pslavkin/cese_kicad/README.md

# cese_kicad
tp para cese sobre kicad

Autor: Pablo Slavkin
CESE2018

Driver motores paso a paso
===========================

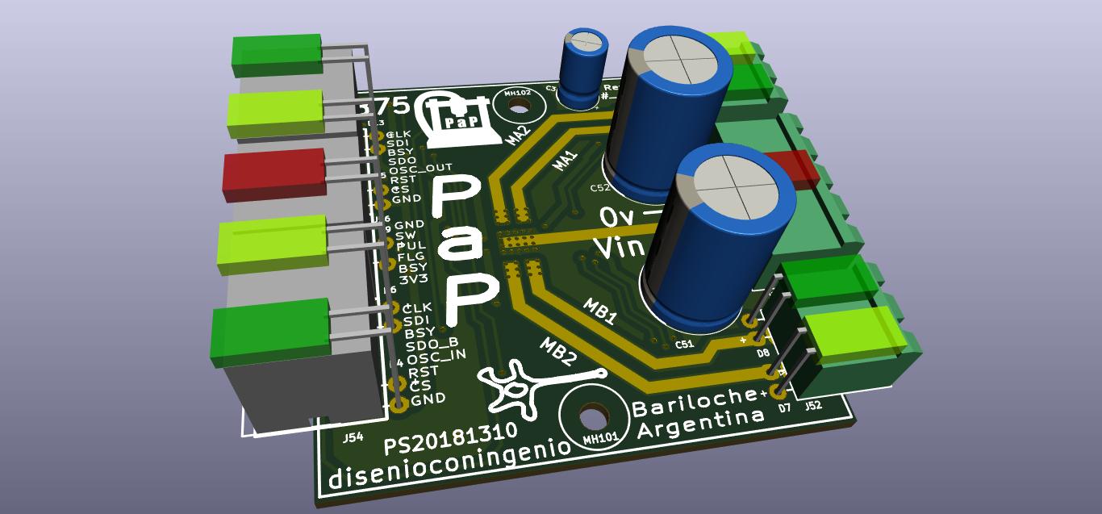
[picture p1: pics/vista3d_1.jpg]
Vista 3d
