pslavkin/cese_kicad/pics/bottom.png

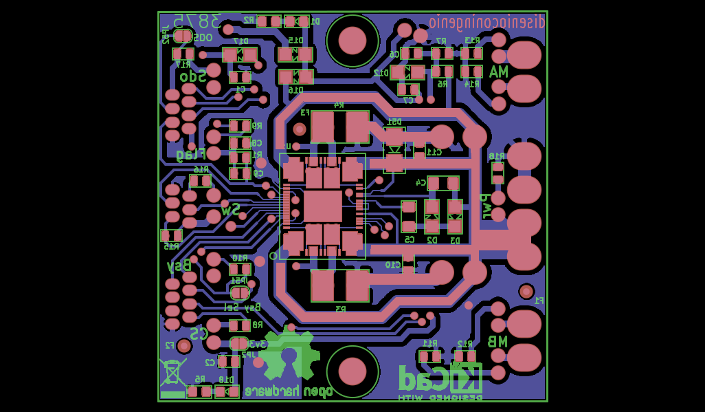
pics/bottom.png
