pslavkin/cese_kicad/pics/top.png

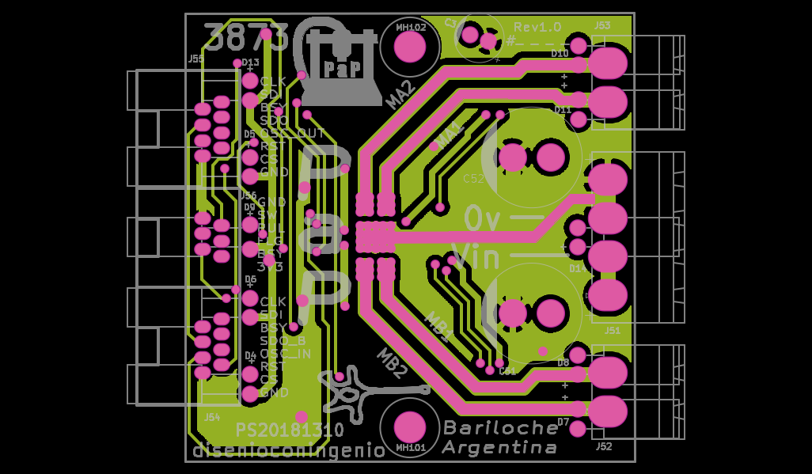
pics/top.png
