pslavkin/cese_kicad/3d/led_5x2_enchufable.fcstd

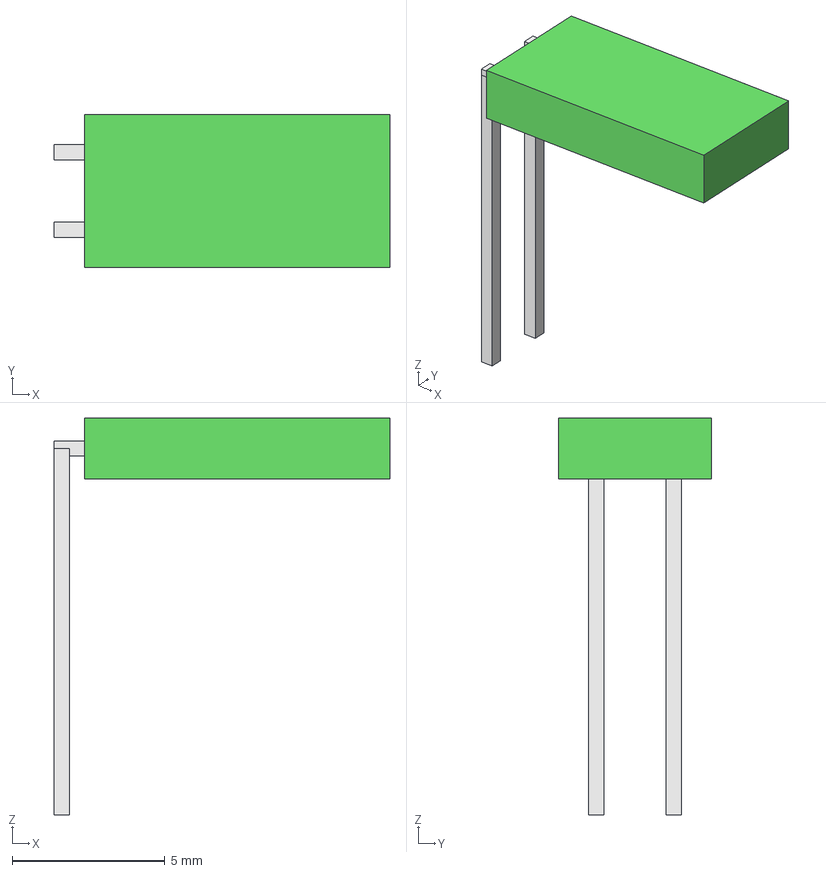
[picture p4: CAD file, 2018-10-18]
3d/led_5x2_enchufable.fcstd
11.0 x 5.00 x 13.0 mm
Clone of Cube001
Clone of Cube002
