pslavkin/cese_kicad/3d/led_5x2_rj.fcstd

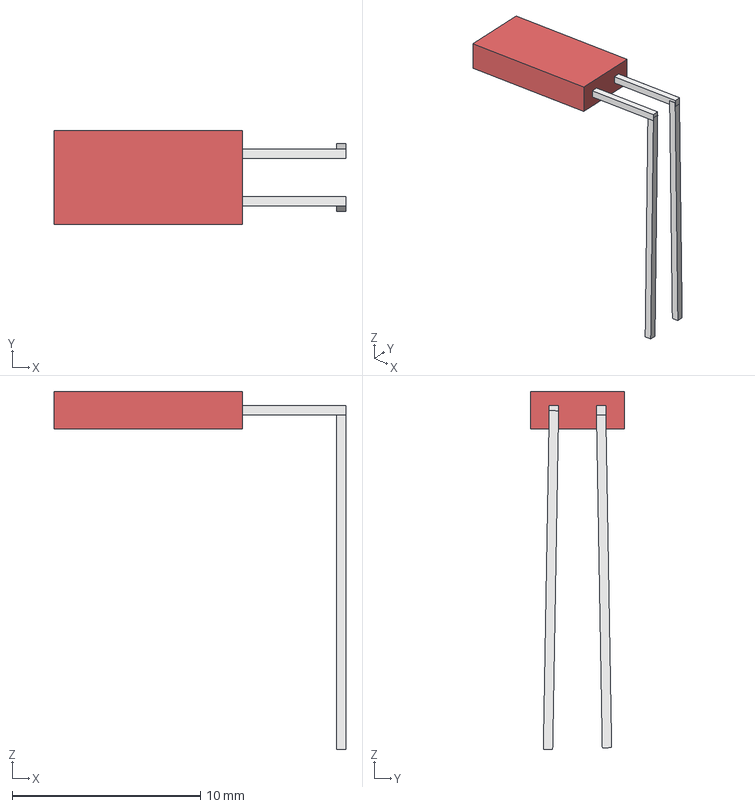
[picture p5: CAD file, 2018-10-18]
3d/led_5x2_rj.fcstd
15.5 x 5.00 x 19.0 mm
Clone of Cube001
Clone of Cube002
