pslavkin/cese_kicad/3d/led.fcstd

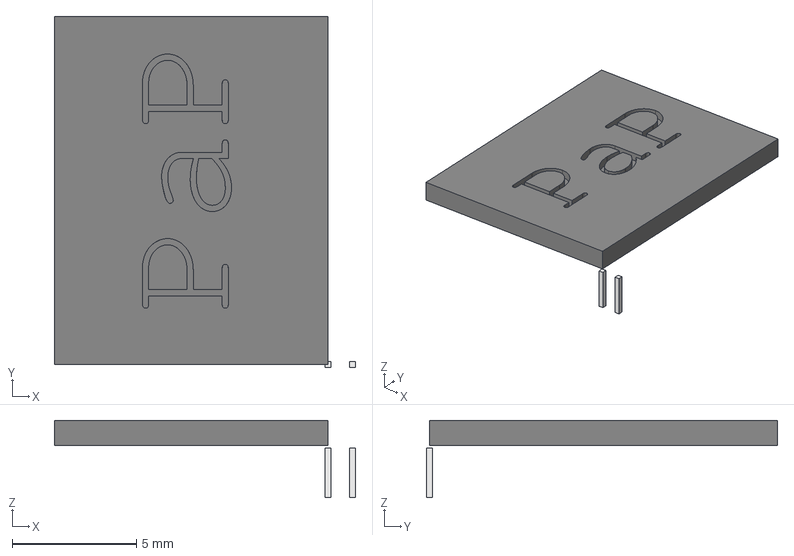
[picture p6: CAD file, 2018-10-13]
3d/led.fcstd
12.1 x 14.1 x 3.10 mm
Clone of Cube
