pslavkin/cese_kicad/(list of files, cad)

Other CAD files:
3d/led2.fcstd
