pslavkin/cese_kicad/pap.kicad_pcb

## KiCad design pap.kicad_pcb (2018-11-28)

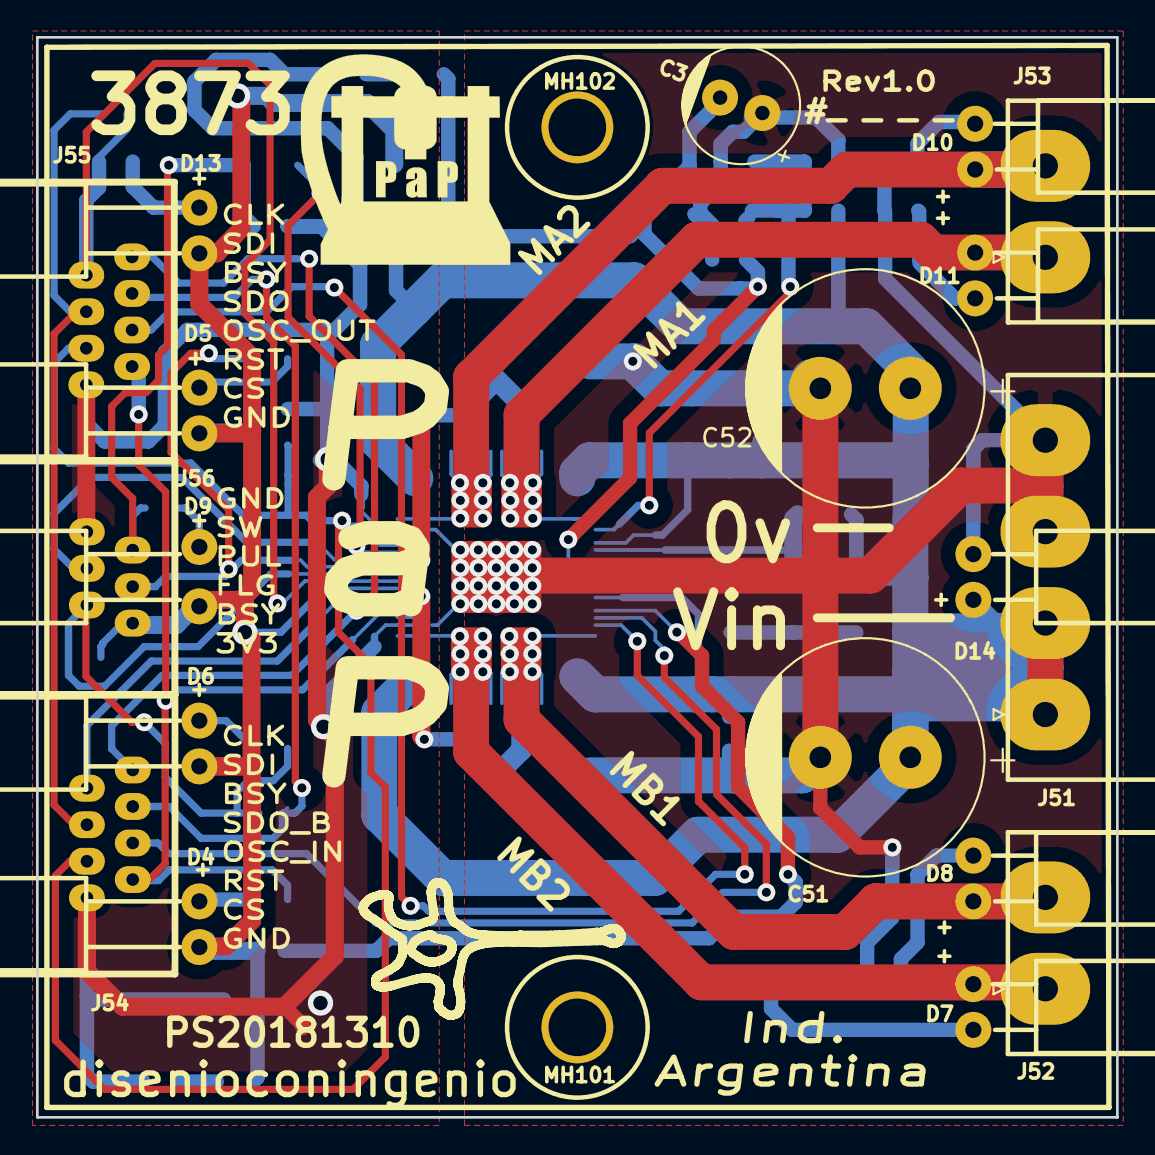
[picture p11: board pap.kicad_pcb from above]

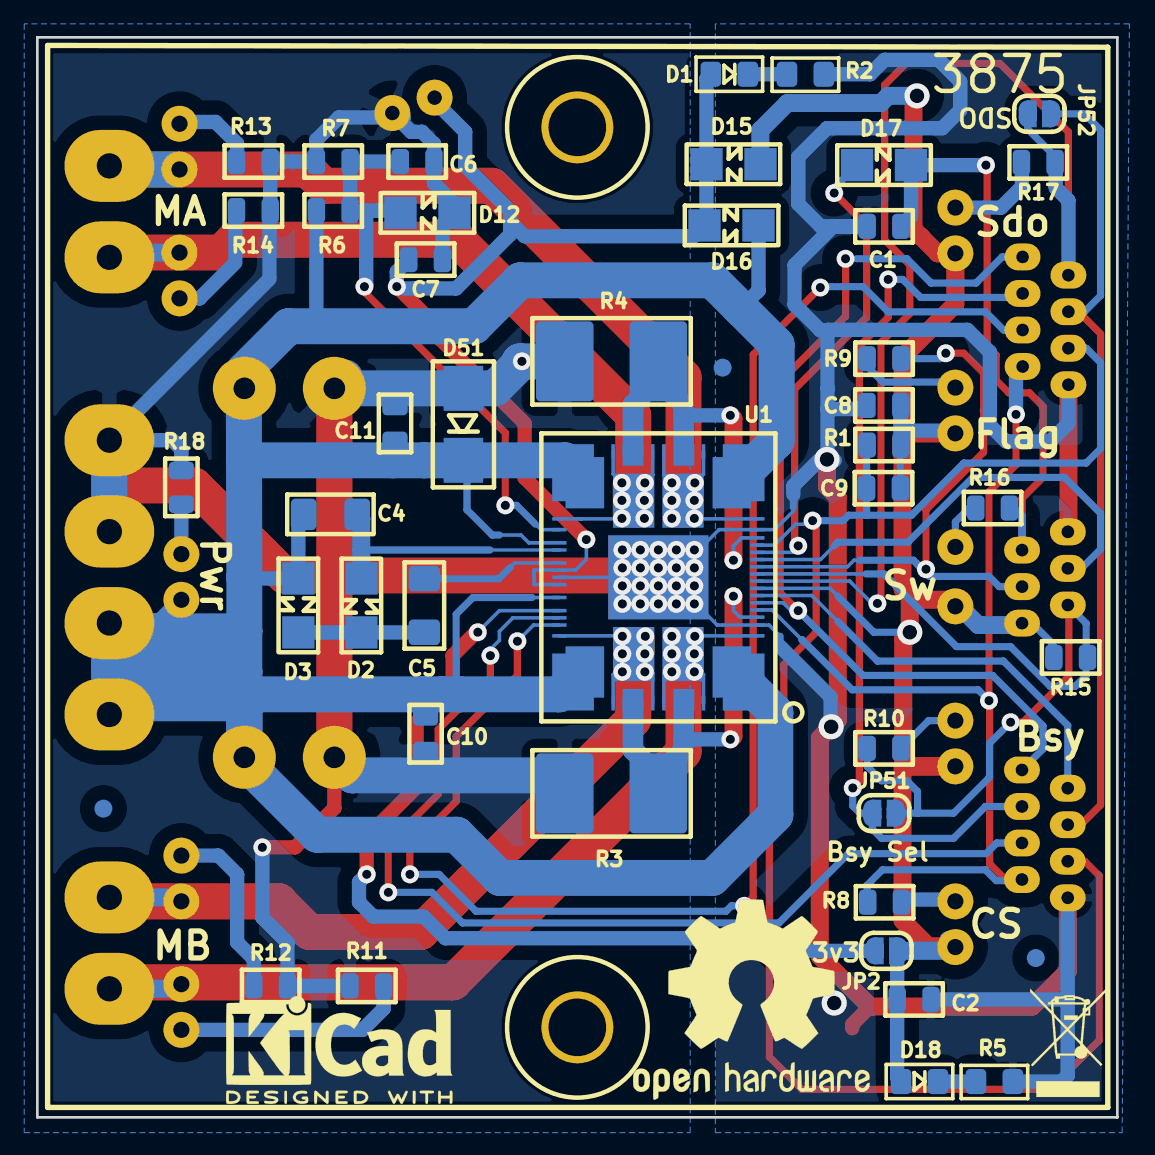
[picture p12: board pap.kicad_pcb from below]

Board: 2 copper layers, 60.0 x 60.0 mm, 72 parts (49 on the bottom side), 42 nets.

Parts:
C1: 10n; C_0805_2012Metric
C2, C6, C7, C8, C9, C10, C11: 100n; C_0805_2012Metric
C3: 220uFx25v; CP_Radial_D6.3mm_P2.50mm
C4, C5: 220n; C_1206_3216Metric_Pad1.42x1.75mm_HandSolder
C51, C52: 100uFx100v; CP_Radial_D13.0mm_P5.00mm
D1, D18: LED_SMD; Wo_Paste_LED_0805_2012Metric_Pad1.15x1.40mm_HandSolder
D2, D3, D15, D16, D17: LL4148; D_MiniMELF
D4, D13: LED; led5x2_rj_verde
D5, D6: LED; led5x2_rj_amarillo
D7: LED; led5x2_enchufable_amarillo
D8: LED_I; led5x2_enchufable_verde
D9: LED; led5x2_rj_rojo_abierto
D10: LED_I; led5x2_enchufable_amarillo
D11: LED; led5x2_enchufable_verde
D12: 3v3; D_MiniMELF
D14: LED_I; led5x2_enchufable_rojo
D51: SM4007; D_SMA
F1, F2, F3: Fiducial; Fiducial_1mm_Dia_2mm_Outer
J51: Conn_01x04; PhoenixContact_MSTBA_2,5_4-G-5,08_1x04_P5.08mm_Horizontal
J52, J53: Conn_01x02; PhoenixContact_MSTBA_2,5_2-G-5,08_1x02_P5.08mm_Horizontal
J54, J55: RJ45; rj45
J56: RJ12; rj12
JP2, JP51, JP52: jumper; SolderJumper-2_P1.3mm_Open_RoundedPad1.0x1.5mm
L101: logo_dci; logo_neurona_15mm
L102: logo_kicad; KiCad-Logo2_6mm_SilkScreen
L104: logo_cnc; cnc
L401: logo_recyclado; WEEE-Logo_4.2x6mm_SilkScreen
LOGO103: Logo_Open_Hardware_Small; OSHW-Logo2_14.6x12mm_SilkScreen
MH101, MH102: 3mm; MountingHole_3.2mm_M3
NT51, NT52: Net-Tie_2; NetTie-2_SMD_Pad0.2mm_sin_seri
R1, R11, R12, R13, R14, R18: 10k; R_0805_2012Metric
R2: 1k5; Wo_Paste_R_0805_2012Metric_Pad1.15x1.40mm_HandSolder
R3, R4: 0.1e; R_2816_7142Metric_Pad3.20x4.45mm_HandSolder
R5: 100e; Wo_Paste_R_0805_2012Metric_Pad1.15x1.40mm_HandSolder
R6: 100k; R_0805_2012Metric
R7: 3k3; R_0805_2012Metric
R8, R9, R10, R16, R17: 100e; R_0805_2012Metric
R15: R; R_0805_2012Metric
U1: powerstep01; powerstep

Connections:
3V3: C2.2, C8.2, C9.2, D4.2, D5.2, D6.2, D9.2, D13.2, D15.2, D18.1, J56.1, JP2.1, R1.2, R15.2, U1.13
15v: C3.2, C7.2, D1.1, D15.1, D16.2, U1.58, U1.60
85v: C4.2, C10.2, C11.2, C51.1, C52.1, D3.2, D14.1, D16.1, D51.1, J51.1, J51.2, R6.1, U1.32, U1.43, U1.55, U1.61, U1.75, U1.86
/connector/Busy: J56.2, JP51.2, R10.1, R15.1, U1.15
/connector/Busy_Out: J54.6, J55.6, JP51.1
/connector/CLK: J54.8, J55.8, U1.11
/connector/CS: J54.2, J55.2, R8.1, U1.10
/connector/Flag: J56.3, R9.1, U1.16
/connector/MotorA1: D11.2, J53.1, U1.38, U1.42, U1.53, U1.92
/connector/MotorA2: D10.1, J53.2, U1.22, U1.33, U1.37, U1.91
/connector/MotorB1: D8.1, J52.2, U1.65, U1.76, U1.80, U1.94
/connector/MotorB2: D7.2, J52.1, U1.7, U1.81, U1.85, U1.90
/connector/Osc_In: J54.4, U1.63
/connector/Osc_Out: J55.4, U1.64
/connector/Pulse: J56.4, U1.17
/connector/Reset: C9.1, J54.3, J55.3, R1.1, U1.19
/connector/SDI: J54.7, U1.12
/connector/SDO: J55.7, JP52.1, R17.1, U1.14
/connector/Sdo_Back: J54.5, J55.5, JP52.2
/connector/Switch: C1.2, D17.1, J56.5, R16.1
/motor/Adc: C6.2, D12.1, R6.2, R7.1, U1.54
/motor/Cpump: C5.1, U1.57
/motor/SenseA: R4.1, U1.20, U1.35, U1.40
/motor/SenseB: R3.1, U1.9, U1.78, U1.83
/motor/Switch_Local: D17.2, U1.18
/motor/Vboot: C4.1, D2.1, U1.56
G3V3: C1.1, C2.1, C8.1, J54.1, J55.1, J56.6, NT51.2, NT52.2, R2.1, R5.1, U1.8, U1.21
G85V: C3.1, C6.1, C7.1, C10.1, C11.1, C51.2, C52.2, D12.2, D51.2, J51.3, J51.4, NT51.1, NT52.1, R3.2, R4.2, R7.2, R11.1, R12.1, R13.1, R14.1, R18.1, U1.59, U1.93
unnamed: C5.2, D2.2, D3.1
unnamed: D1.2, R2.2
unnamed: D4.1, R8.2
unnamed: D5.1, R9.2
unnamed: D6.1, R10.2
unnamed: D7.1, R11.2
unnamed: D8.2, R12.2
unnamed: D9.1, R16.2
unnamed: D10.2, R13.2
unnamed: D11.1, R14.2
unnamed: D13.1, R17.2
unnamed: D14.2, R18.2
unnamed: D18.2, R5.2
Vreg: JP2.2, U1.62
