pslavkin/cese_kicad/pics/pcb_fabricado1.jpeg

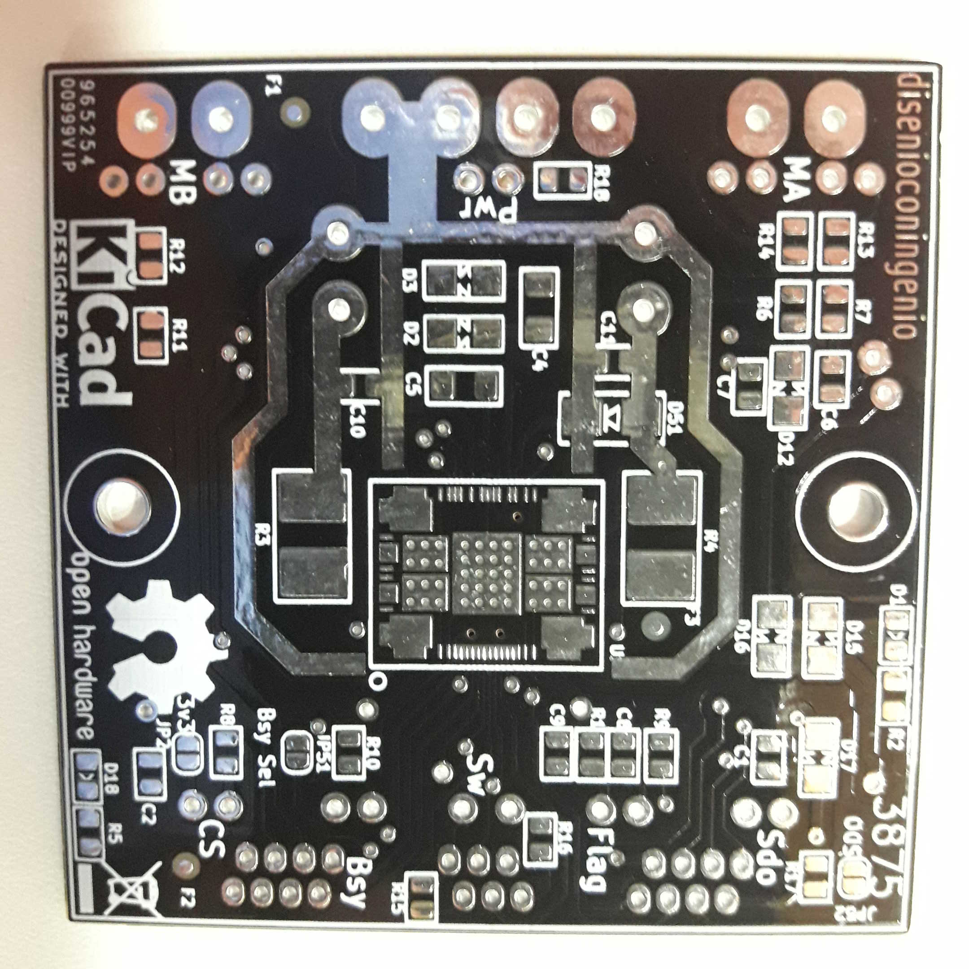
pics/pcb_fabricado1.jpeg
