pslavkin/cese_kicad/pics/pcb_fabricado2.jpeg

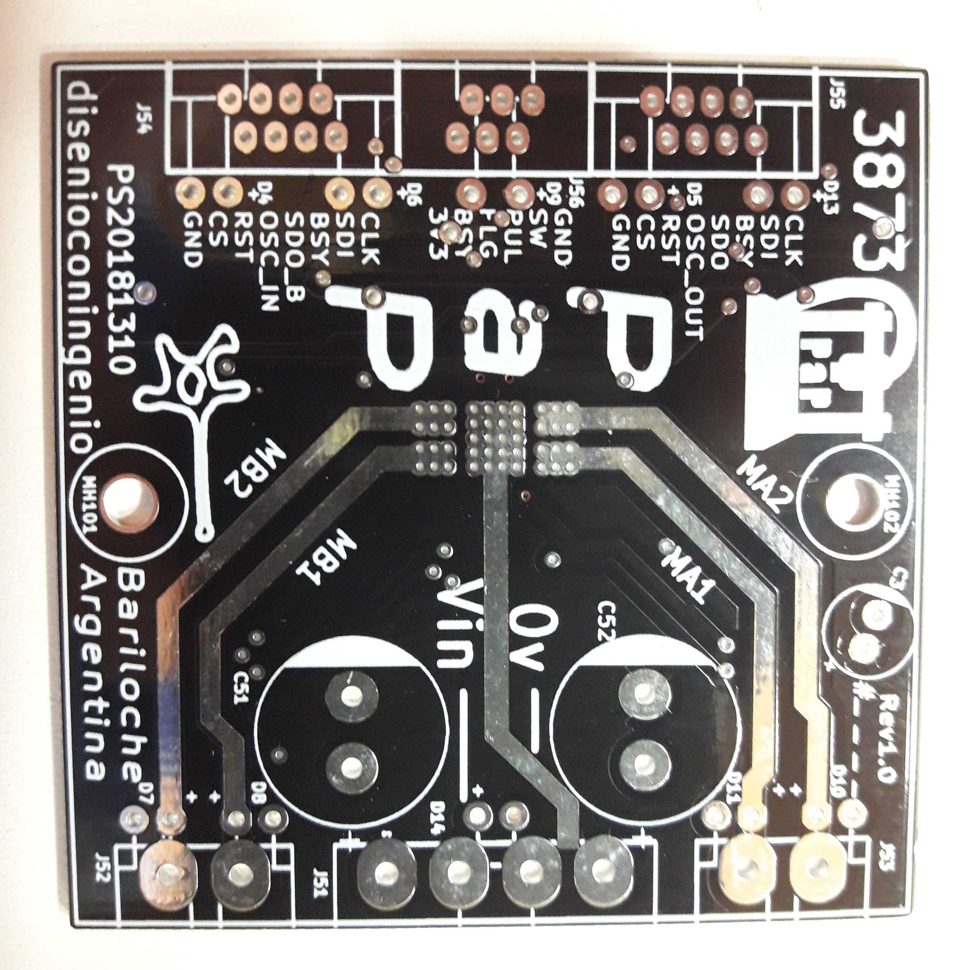
pics/pcb_fabricado2.jpeg
