pslavkin/cese_kicad/(commit log)

2018-09-22 creo symbolo powerstep y arranco a conectar al tiempo de diseniar
    agregue el symbolo del powerstep.. lo hice siguiendo la secuencia de
    pines originales porque me permite utilizar la simetria del chip y ya ir
    pensando en el ruteo, el modo de reorganizar los pines que hizo el
    fabricante quedo igual o peor de desordenado.. prefiero este que ya me
    ayuda a ir viendo la disposicion y ademas aprovechar la simetria. estoy
    viendo como hacer el encadenamiento de spi y clk.. no se si utilizar
    cables o que.. ya vere...le voy agarrando la onda...
    [connector.sch, motor.sch, pap.csv, pap.kicad_pcb, pap.sch]
2018-09-23 agrego mas conectores y paso a pcb (todo mal!)
    agregue conectores RJ45 para el encadenamiento spi y busyflag, pero no
    para pulse.. es lo voy a mandar aparte porque es individual por cada
    driver.. al igual que switch, y vere si alguna cosa mas.. en el rj me
    sobran aun 2 pines.. ya vere que mando..lastima que no puedo mandar
    pulse por ahi.. porque al ser 1 por driver necesito ir directo desde el
    controlador.. sino como?... pase a pcb para ver que onda nada mas y
    obvio me faltan definir los footprints de casi todo.. pero al menos
    paso...orcad ya estaria llorando y no podria hacer nada...como sea, esta
    bueno...sigo
    [connector.sch, motor.sch, pap.kicad_pcb, pap.sch]
2018-09-24 armo huella step01 y asigno casi todas las huellas
    ahi hice el landpattern del steo01, que es un parto, pero quedo bueno..
    al tiempo que aprendi a editar y la verdad es que es comodo.. me animo a
    decir que supera a allegro, y de hecho se parece demasiado en muchas
    cosas.. huele a copia de algun lado.. incluiso los nombres en los menus
    son iguales... como sea, ya quedo eso, lo que si tuve que volar algunos
    pines repetidos en el simbolo porque sino era un chino tener muchos
    pines repetidos, o sea en la huella tengo un pin que va a parar a
    multiples pines en el esquemativo. si bien lo logre hacer superponiendo
    encimados los pines en el esquemativo y dejandolos invisibles excepto
    uno, eso funca,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
    [connector.sch, motor.sch, pap.kicad_pcb, pap.sch]
2018-09-25 arranco a rutear, cambio xtal por SMD y opcion CLKIN
    arranque a tirar pist porque me estaba aburriendo ya, de paso voy
    practivcando los shortcuts y demas.. esta muy copado y te aviso.. es
    plagio a allegro.. no cabe dudas.. como sea, cambie el Xtal por uno SMD
    de 4 pines que se consigue y minimiza el espacio, agegue tambien clkin
    para mandar clk a todos por igual con el PWM del uC para sincronizar con
    un selector para poder usar el xtal si es que el PWM se pierde por
    fanout o ruido.. y no mucho mas
    [connector.sch, motor.sch, pap.kicad_pcb, pap.sch]
2018-09-29 Cambio Rj's vuela xtal, entra Reset, agrego tornillos
    Hago de todo un poco entre lo que saco el xtal porque ya probe que no se
    necesita, elijo un IC que gnere 16Mhz y lo encadeno al resto, el RJ lo
    cambie por otra que se parece mas a la que voy a usar, pero hay que
    verificar, agregue un selector de osc, y agregue unos agujeros de
    tornillos que no se si los quiero. va bien.. tengo que meterle mas al
    ruteo
    [connector.sch, motor.sch, pap.kicad_pcb, pap.sch]
2018-10-05 cambio nombres, hago board edge, defino capas, posicion y demas
    hice de todo un poco, principalmente le di forma a la placa con una
    dimensino pasable, ajuste los conectores que aun no me convencen, pero
    cambie la entrada para el conector de 4 y los motores en 2 de 2, cosa
    que la alimentacion este toda en un solo conector y me queda piola para
    que los motores salgan del IC para los costados. en cuanto a la logica
    aun no me decido si voy a poner otra RJ para la salida d busy y demas o
    meto bornera.. estouy mas del lado de la RJ y me quedaria genial para
    poner los leds arriba de la RJ o a un costado.. puedo elegir eso.. mepa
    que vamos con eso y asi no hay manera de mezclar fichas tampoco, porqu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
    [connector.sch, motor.sch, pap.kicad_pcb, pap.sch]
2018-10-05 achico placa, agrego rj12, defino pistas, ruteo potencia
    ahi le voy dando forma. ya rute la potencia y esta mas o menios bien,
    ahora estoy viendo el tema de los leds para ponmerlos encima de los
    conectores con patas porque es la mejor opcion que se me ocurrio y ya la
    tengo probada.. con leds SMD despues tengo que hacer un chino para
    sacarlo para afuera y de costado necesito acrilico puro para conducir..
    es mas laburo.. con patas hago 2x1.. veremos como queda
    [connector.sch, motor.sch, pap.kicad_pcb, pap.sch]
2018-10-05 sigo ruteando y acomodando ocsas, agrego algunos leds
    [connector.sch, led.fcstd, motor.sch, pap.kicad_pcb]
2018-10-06 ruteo!! no se como pero esta todo conectado!, horrible claro
    conecto todo.. bastamte ofiero pero conecto.. y quedan huevos para ir
    mejorando.. tampoco esta taaaan mal... y las cosas ya estan en su
    lugar.. me quedan varias horas para pulir todo y respetar las reglas de
    cada net y demas.. queda un pedazo todavia pero no esta nada mal..
    lo que si me di cuenta que estaba pensando mal lo de la cadena de spi y
    la de osci, ahora es simple, ficha de in y ficha de out, por la de in
    entra sdi y por la de out sale sdo. el ultimo cierra la puerta puentendo
    su sdo con un pin suelto de sdo_back que lleva hacia atras el sdo final
    y lo termina mandando al uC. o sea es un pin dedicado todo puenteado que
    term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
    [connector.sch, motor.sch, pap.kicad_pcb]
2018-10-13 sigo ruteando, serigrafia mas gruesa, alineacino etc
    [connector.sch, led.fcstd, motor.sch, pap.kicad_pcb]
2018-10-13 agregando mascaras para alambrado de pistas tie-net,
    agregando mascaras para soldar alambres en pistas de potencia, uno con
    tie net gnd de 3 con el gnd de 85, tambien agrego planos de tierra para
    ambos, y asuntos relacionados con eso. mejor el 3d de las rj;s, agrego
    gerbers del fabricante, recien lo veo!! pero se parece bastante a lo que
    hice..
    [connector.sch, motor.sch, pap.kicad_pcb]
2018-10-13 cambio de nombres, mejorop serigrafia, agrego pin
    agrego el pin de flag ya que me sobraba un pin en el RJ12, cambio los
    nombres de 0-50 para motor y 51 a 100 para conector, ajusto el espesor
    de la seri, y algunas cosas mas..
    [connector.sch, motor.sch, pap.kicad_pcb, pap.sch]
2018-10-14 aghrego serigrafia, logos, faltan fiduciales aun
    [connector.sch, misc.sch, motor.sch, pap.kicad_pcb, pap.sch]
2018-10-14 voy terminando, me falta sacar los gerbers.. a por ellos...
    [misc.sch, pap.kicad_pcb, pap.sch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]
2018-10-14 agrego gerbers.. va quedando peeero falta crc de layout
    ahi lo voy liquidando, me convence, pero me falta tirar el crc en layout
    que tiene muchos errores principalmente por el tema de que para una
    misma net tengo varias restriccinoes solapadas.. vere como hago con eso
    y lo cierro.. ser maniana.. me estoy durmiendo..
    ha, cambio tambien un poco la jerarquia de dirs asi queda mas ordenadito
    [connector.sch, misc.sch, motor.sch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]
2018-10-14 me habia olvidado algunos capas, agrego leds, me falta aun
    no estaba poniendo los descaoples de los reguladores internos y hay uno
    de 220uF! ese lo mando TH, igual voy a verificar en el PCB de st. pero
    igual me faltaban tambien los capas de 3v3 y 85v tambien.. veo donde los
    meto
    [connector.sch, misc.sch, motor.sch, pap.kicad_pcb, pap.sch]
2018-10-18 termino ruteo, genero gerbers y drills, y entrego
    Listo pisto, lo dejo asi, ya lo revise varias veces, agregue los
    desacoples y el bulk pendiente, coloreo leds con nuevo 3d, genero
    gerners, y agrego valores a los componentes. ha y tambien dejo PTH los
    agujeros de los tornillos, quedan mejor. y no mucho mas.. entrego ya!
    [led2.fcstd, led_5x2_enchufable.fcstd, led_5x2_rj.fcstd, motor.sch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]
2018-10-19 agreo fabricante y algun detalle menor en pcb
    solo agrego unos detalles en fab de pcb indicando vias, pistas y
    tecnologia de fabricacion. algo tenia, completo algun detalle mas
    [pap.kicad_pcb]
2018-10-19 reviso y ajusto minimo track global a 0.25
    en realidad el iC requiere de track de 0.2, pero el resto de la placa
    intento llegar a 0.25 para tecnologia de 10/10 mils, y generalmente se
    acepta que para el integrado sea un poco mayor que para el ruteo.
    veremos.. lo dejo en 0.25/0.25
    [pap.kicad_pcb]
2018-10-19 error en el path de pics en Readme, corrijo
2018-10-22 agfego valores faltantes de capas
    Gracias al aporte de Gonzalo, me habian quedado algunos capas sin valor.
    .Corrijo. Hay otras sugerencias de Gonzalo que no se corrigen, solo se
    consideran y se evaluaran luego
    [motor.sch, pap.kicad_pcb, pap.sch]
2018-11-28 Agrego modelos 3d locales, y corrijo lo solicitado por Diego
    Ahi agregue las correcciones que me paso Diego y agregue los modelos 3d
    en el repo local que no estaban. el resto fueron ajustes menores.
    Tambien agregue las fotos del proto fabricado
    [connector.sch, misc.sch, motor.sch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]
